fliperama86/pico-retrodigital/hardware/pico-retrodigital/pico-retrodigital.kicad_pcb

## KiCad design hardware/pico-retrodigital/pico-retrodigital.kicad_pcb (2026-08-05)

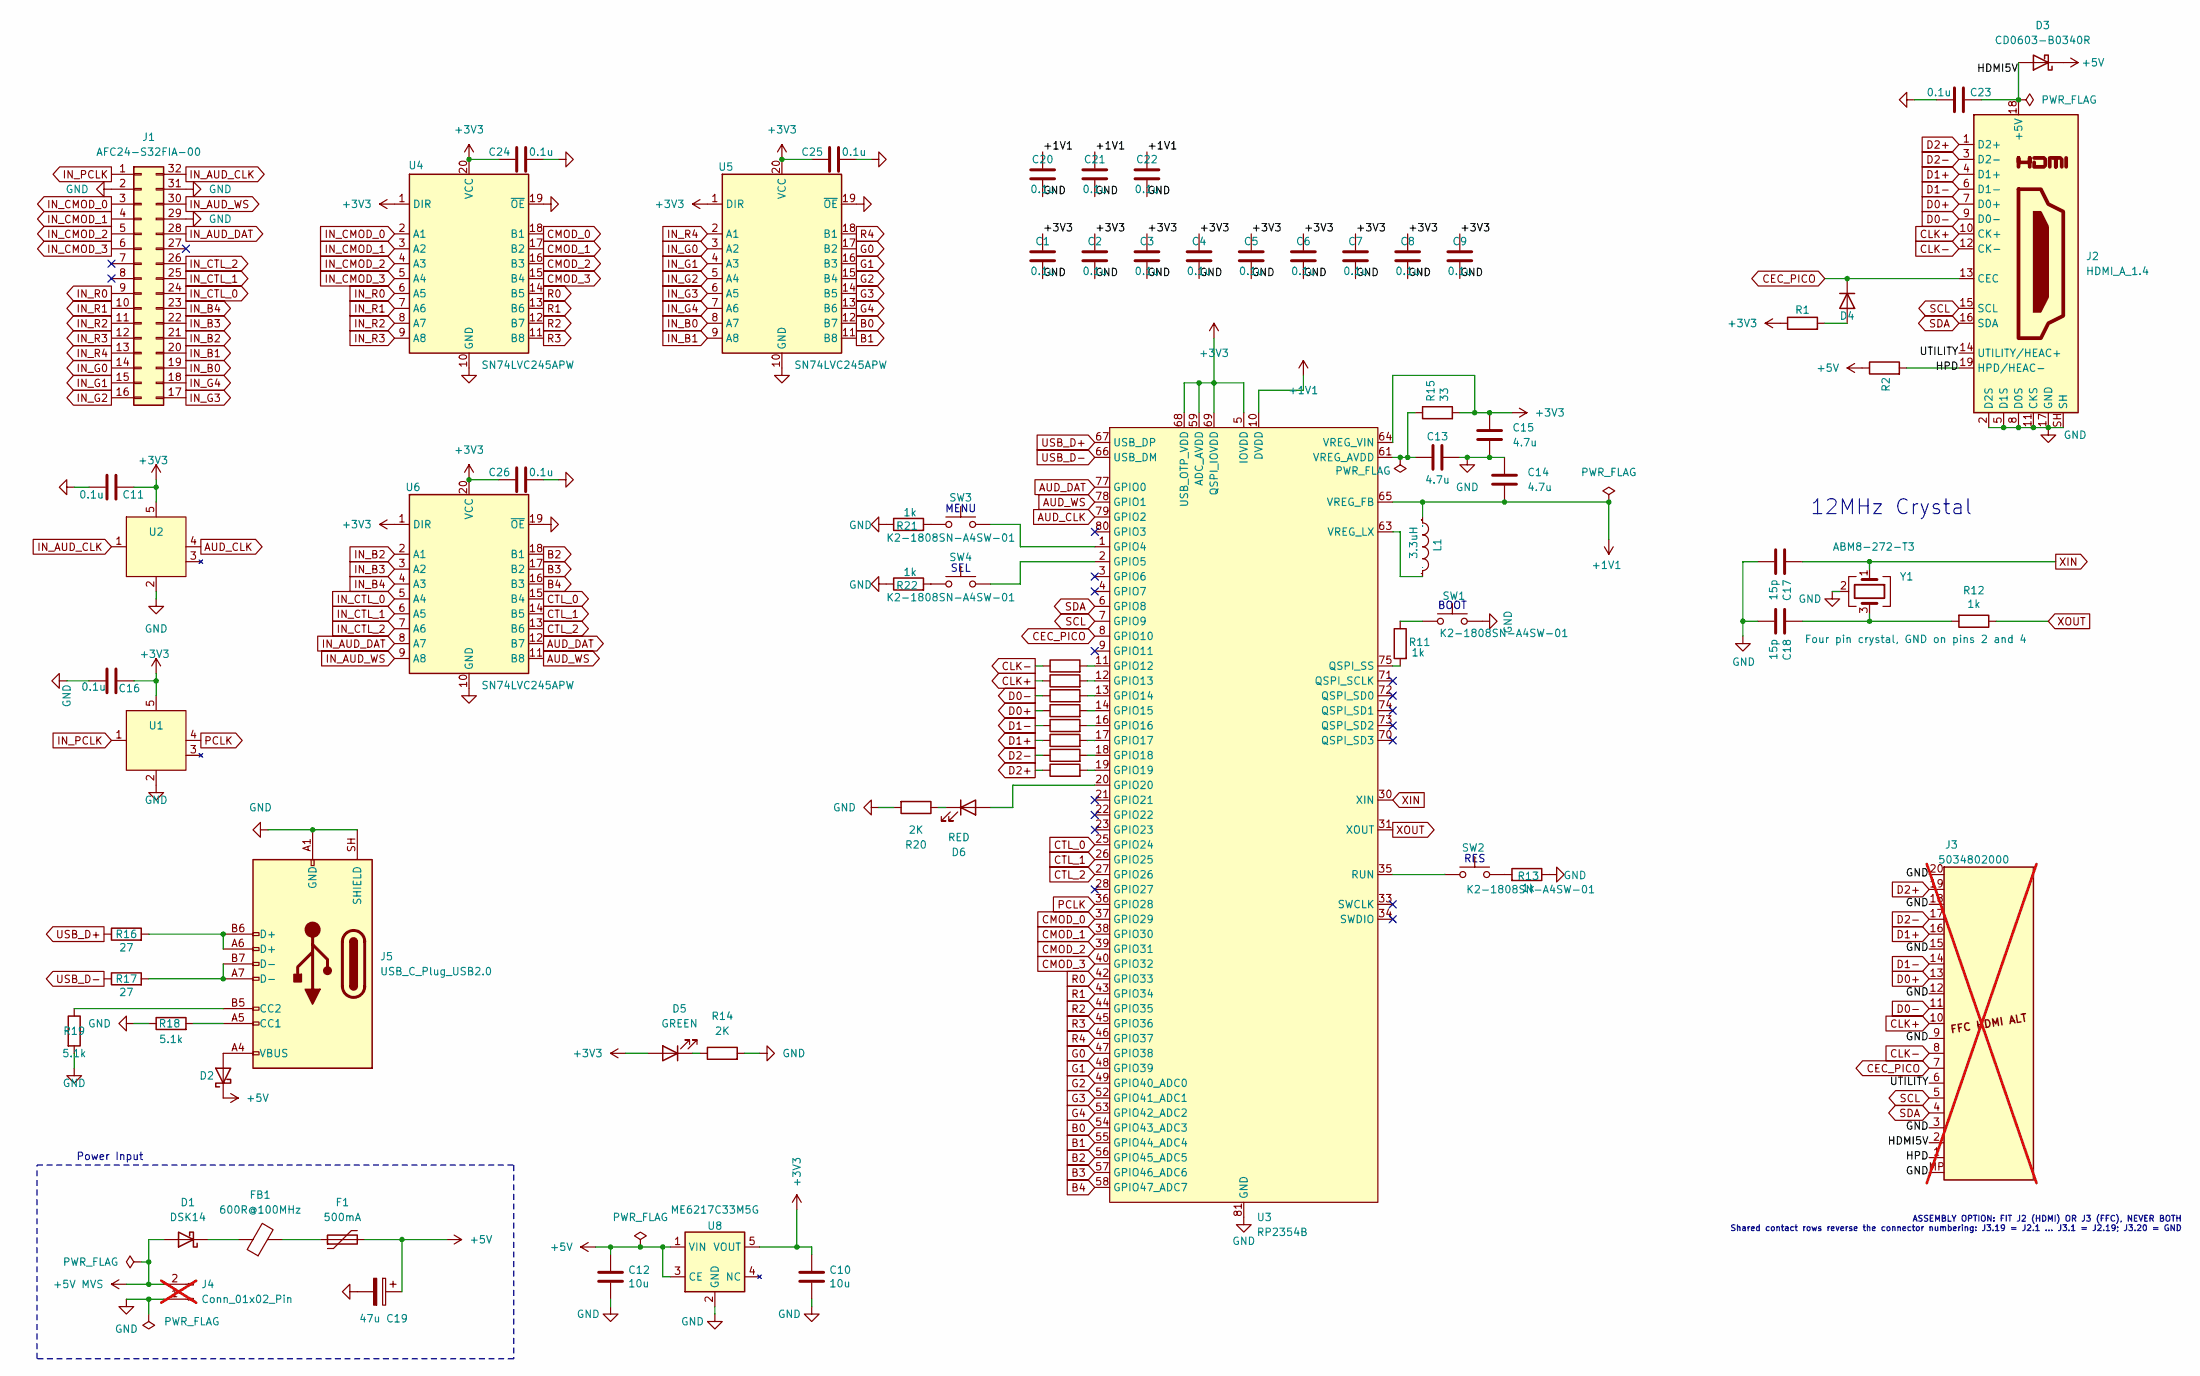
[picture p1: schematic pico-retrodigital.kicad_sch]

Parts:
C1, C3, C4, C5, C6, C7, C8, C9, C11, C16, C20, C21, C22, C23, C24, C25, C26: 0.1u; C_0402_1005Metric; LCSC C1525
C2: 0.1u; C_0603_1608Metric; LCSC C14663
C10, C12: 10u; C_0402_1005Metric; LCSC C15525
C13, C15: 4.7u; C_0402_1005Metric; LCSC C23733
C14: 4.7u; C_0603_1608Metric; LCSC C19666
C17, C18: 15p; C_0402_1005Metric; LCSC C1548
C19: 47u; C_1206_3216Metric; MPN CL31A476MPHNNNE; LCSC C96123
D1: DSK14; D_SOD-123; LCSC C7502711
D2: DSK14; D_SOD-123; MPN DSK14; LCSC C7502711
D3, D4: CD0603-B0340R; D_0603_1608Metric; MPN CD0603-B0340R; LCSC C3759853
D5: GREEN; LED_0603_1608Metric; MPN KT-0603YG; LCSC C2289
D6: RED; LED_0603_1608Metric; MPN KT-0603R; LCSC C2286
F1: 500mA; C_0603_1608Metric; MPN BSMD0603-050-6V; LCSC C883095
FB1: 600R@100MHz; C_0603_1608Metric; MPN BLM18KG601SN1D; LCSC C85833
J1: AFC24-S32FIA-00; FPC-SMD_P0.50-32P_JS_AFC24-S32FIA-00; MPN AFC24-S32FIA-00; LCSC C2908587
J2: HDMI_A_1.4; HDMI_A_Molex_208658-1001_Horizontal; MPN HDMI-001 19PCBTP; LCSC C138388
J3: 5034802000; FPC-SMD_5034802000; MPN 5034802000; LCSC C234192; not fitted
J4: Conn_01x02_Pin; JST_XA_B02B-XASK-1_1x02_P2.50mm_Vertical; MPN B02B-XASK-1(LF)(SN); LCSC C263753; not fitted
J5: USB_C_Plug_USB2.0; USB_C_Receptacle_HRO_TYPE-C-31-M-12; MPN TYPE-C-31-M-12; LCSC C165948
L1: IND-SMD_L2.0-W1.6_AOTA-B201610S3R3-101-T; Manufacturer Part AOTA-B201610S3R3-101-T; LCSC Part Name AOTA-B201610S3R3-101-T
R1: 27K; R_0402_1005Metric; LCSC C25771
R2: 10K; R_0603_1608Metric; LCSC C25804
R3, R4, R5, R6, R7, R8, R9, R10: 220; R_0402_1005Metric; LCSC C25091
R11, R12, R13, R21, R22: 1k; R_0402_1005Metric; LCSC C11702
R14, R20: 2K; R_0402_1005Metric; LCSC C4109
R15: 33; R_0402_1005Metric; LCSC C25105
R16, R17: 27; R_0603_1608Metric; LCSC C25190
R18, R19: 5.1k; R_0603_1608Metric; LCSC C23186
SW1, SW2, SW3, SW4: K2-1808SN-A4SW-01; SW_Push_1P1T_NO_Vertical_Wuerth_434133025816; LCSC C92589
U1, U2: SN74LVC1G17DBVR; SOT-23-5; LCSC C7836
U3: RP2354B; QFN-80-1EP_10x10mm_P0.4mm_EP3.4x3.4mm_ThermalVias; LCSC C39843328
U4, U5, U6: SN74LVC245APW; TSSOP-20_4.4x6.5mm_P0.65mm; LCSC C7848
U8: ME6217C33M5G; SOT-23-5; LCSC C427602
Y1: ABM8-272-T3; Crystal_SMD_3225-4Pin_3.2x2.5mm; LCSC C20625731

Connections:
+1V1: C14.2, C20.1, C21.1, C22.1, L1.1, U3.10 (DVDD), U3.32 (DVDD), U3.51 (DVDD), U3.65 (VREG_FB)
+3V3: C1.1, C2.1, C3.1, C4.1, C5.1, C6.1, C7.1, C8.1, C9.1, C10.1, C11.1, C15.1, C16.1, C24.1, C25.1, C26.1, D5.2 (A), R1.1, R15.2, U1.5 (VCC), U2.5 (VCC), U3.5 (IOVDD), U3.15 (IOVDD), U3.24 (IOVDD), U3.29 (IOVDD), U3.41 (IOVDD), U3.50 (IOVDD), U3.59 (ADC_AVDD), U3.60 (IOVDD), U3.64 (VREG_VIN), U3.68 (USB_OTP_VDD), U3.69 (QSPI_IOVDD), U3.76 (IOVDD), U4.1 (DIR), U4.20 (VCC), U5.1 (DIR), U5.20 (VCC), U6.1 (DIR), U6.20 (VCC), U8.5 (VOUT)
+5V: C12.1, C19.1, D2.1 (K), D3.1 (K), F1.2, R2.1, U8.1 (VIN), U8.3 (CE)
+5V MVS: D1.2 (A), J4.2
/HDMI5V: C23.1, D3.2 (A), J2.18 (+5V), J3.2 (+5V)
/HPD: J2.19 (HPD/HEAC-), J3.1 (HPD), R2.2
/UTILITY: J2.14 (UTILITY/HEAC+), J3.6 (UTILITY)
AUD_CLK: U2.4 (Y), U3.79 (GPIO2)
AUD_DAT: U3.77 (GPIO0), U6.12 (B7)
AUD_WS: U3.78 (GPIO1), U6.11 (B8)
B0: U3.54 (GPIO43_ADC3), U5.12 (B7)
B1: U3.55 (GPIO44_ADC4), U5.11 (B8)
B2: U3.56 (GPIO45_ADC5), U6.18 (B1)
B3: U3.57 (GPIO46_ADC6), U6.17 (B2)
B4: U3.58 (GPIO47_ADC7), U6.16 (B3)
CEC_PICO: D4.1 (K), J2.13 (CEC), J3.7 (CEC), U3.8 (GPIO10)
CLK+: J2.10 (CK+), J3.10 (CLK+), R5.1
CLK-: J2.12 (CK-), J3.8 (CLK-), R4.1
CMOD_0: U3.37 (GPIO29), U4.18 (B1)
CMOD_1: U3.38 (GPIO30), U4.17 (B2)
CMOD_2: U3.39 (GPIO31), U4.16 (B3)
CMOD_3: U3.40 (GPIO32), U4.15 (B4)
CTL_0: U3.25 (GPIO24), U6.15 (B4)
CTL_1: U3.26 (GPIO25), U6.14 (B5)
CTL_2: U3.27 (GPIO26), U6.13 (B6)
D0+: J2.7 (D0+), J3.13 (D0+), R6.1
D0-: J2.9 (D0-), J3.11 (D0-), R3.1
D1+: J2.4 (D1+), J3.16 (D1+), R8.1
D1-: J2.6 (D1-), J3.14 (D1-), R7.1
D2+: J2.1 (D2+), J3.19 (D2+), R10.1
D2-: J2.3 (D2-), J3.17 (D2-), R9.1
G0: U3.47 (GPIO38), U5.17 (B2)
G1: U3.48 (GPIO39), U5.16 (B3)
G2: U3.49 (GPIO40_ADC0), U5.15 (B4)
G3: U3.52 (GPIO41_ADC1), U5.14 (B5)
G4: U3.53 (GPIO42_ADC2), U5.13 (B6)
GND: C1.2, C2.2, C3.2, C4.2, C5.2, C6.2, C7.2, C8.2, C9.2, C10.2, C11.2, C12.2, C13.2, C14.1, C15.2, C16.2, C17.2, C18.2, C19.2, C20.2, C21.2, C22.2, C23.2, C24.2, C25.2, C26.2, J1.2, J1.29, J1.31, J2.2 (D2S), J2.5 (D1S), J2.8 (D0S), J2.11 (CKS), J2.17 (GND), J2.SH, J3.3 (GND), J3.9 (GND), J3.12 (GND), J3.15 (GND), J3.18 (GND), J3.20 (GND), J3.MP (SHIELD), J4.1, J5.A1 (GND), J5.A12 (GND), J5.B1 (GND), J5.B12 (GND), J5.SH (SHIELD), R13.1, R14.2, R18.1, R19.2, R20.2, R21.1, R22.1, SW1.1, U1.2 (GND), U2.2 (GND), U3.62 (VREG_PGND), U3.81 (GND), U4.10 (GND), U4.19 (~OE), U5.10 (GND), U5.19 (~OE), U6.10 (GND), U6.19 (~OE), U8.2 (GND), Y1.2 (G), Y1.4 (G)
IN_AUD_CLK: J1.32, U2.1 (A)
IN_AUD_DAT: J1.28, U6.8 (A7)
IN_AUD_WS: J1.30, U6.9 (A8)
IN_B0: J1.19, U5.8 (A7)
IN_B1: J1.20, U5.9 (A8)
IN_B2: J1.21, U6.2 (A1)
IN_B3: J1.22, U6.3 (A2)
IN_B4: J1.23, U6.4 (A3)
IN_CMOD_0: J1.3, U4.2 (A1)
IN_CMOD_1: J1.4, U4.3 (A2)
IN_CMOD_2: J1.5, U4.4 (A3)
IN_CMOD_3: J1.6, U4.5 (A4)
IN_CTL_0: J1.24, U6.5 (A4)
IN_CTL_1: J1.25, U6.6 (A5)
IN_CTL_2: J1.26, U6.7 (A6)
IN_G0: J1.14, U5.3 (A2)
IN_G1: J1.15, U5.4 (A3)
IN_G2: J1.16, U5.5 (A4)
IN_G3: J1.17, U5.6 (A5)
IN_G4: J1.18, U5.7 (A6)
IN_PCLK: J1.1, U1.1 (A)
IN_R0: J1.9, U4.6 (A5)
IN_R1: J1.10, U4.7 (A6)
IN_R2: J1.11, U4.8 (A7)
IN_R3: J1.12, U4.9 (A8)
IN_R4: J1.13, U5.2 (A1)
unnamed: C18.1, R12.2, Y1.3
unnamed: D1.1 (K), FB1.1
unnamed: D2.2 (A), J5.A4 (VBUS), J5.A9 (VBUS), J5.B4 (VBUS), J5.B9 (VBUS)
unnamed: D4.2 (A), R1.2
unnamed: D5.1 (K), R14.1
unnamed: D6.2 (A), U3.20 (GPIO20)
unnamed: D6.1 (K), R20.1
unnamed: F1.1, FB1.2
unnamed: J5.A5 (CC1), R18.2
unnamed: J5.B5 (CC2), R19.1
unnamed: J5.A6 (D+), J5.B6 (D+), R16.2
unnamed: J5.A7 (D-), J5.B7 (D-), R17.2
unnamed: R11.1, SW1.2
unnamed: R13.2, SW2.1
unnamed: R21.2, SW3.1
unnamed: R22.2, SW4.1
unnamed: SW3.2, U3.1 (GPIO4)
unnamed: SW4.2, U3.2 (GPIO5)
unnamed: R4.2, U3.11 (GPIO12)
unnamed: R5.2, U3.12 (GPIO13)
unnamed: R3.2, U3.13 (GPIO14)
unnamed: R6.2, U3.14 (GPIO15)
unnamed: R7.2, U3.16 (GPIO16)
unnamed: R8.2, U3.17 (GPIO17)
unnamed: R9.2, U3.18 (GPIO18)
unnamed: R10.2, U3.19 (GPIO19)
unnamed: R11.2, U3.75 (QSPI_SS)
unnamed: SW2.2, U3.35 (RUN)
unnamed: C13.1, R15.1, U3.61 (VREG_AVDD)
unnamed: L1.2, U3.63 (VREG_LX)
PCLK: U1.4 (Y), U3.36 (GPIO28)
R0: U3.42 (GPIO33), U4.14 (B5)
R1: U3.43 (GPIO34), U4.13 (B6)
R2: U3.44 (GPIO35), U4.12 (B7)
R3: U3.45 (GPIO36), U4.11 (B8)
R4: U3.46 (GPIO37), U5.18 (B1)
SCL: J2.15 (SCL), J3.5 (SCL), U3.7 (GPIO9)
SDA: J2.16 (SDA), J3.4 (SDA), U3.6 (GPIO8)
USB_D+: R16.1, U3.67 (USB_DP)
USB_D-: R17.1, U3.66 (USB_DM)
XIN: C17.1, U3.30 (XIN), Y1.1
XOUT: R12.1, U3.31 (XOUT)

Notes on the sheet:
Power Input
12MHz Crystal
SEL
ASSEMBLY OPTION: FIT J2 (HDMI) OR J3 (FFC), NEVER BOTH Shared contact rows reverse the connector numbering: J3.19 = J2.1 ... J3.1 = J2.19; J3.20 = GND
MENU
RES
BOOT

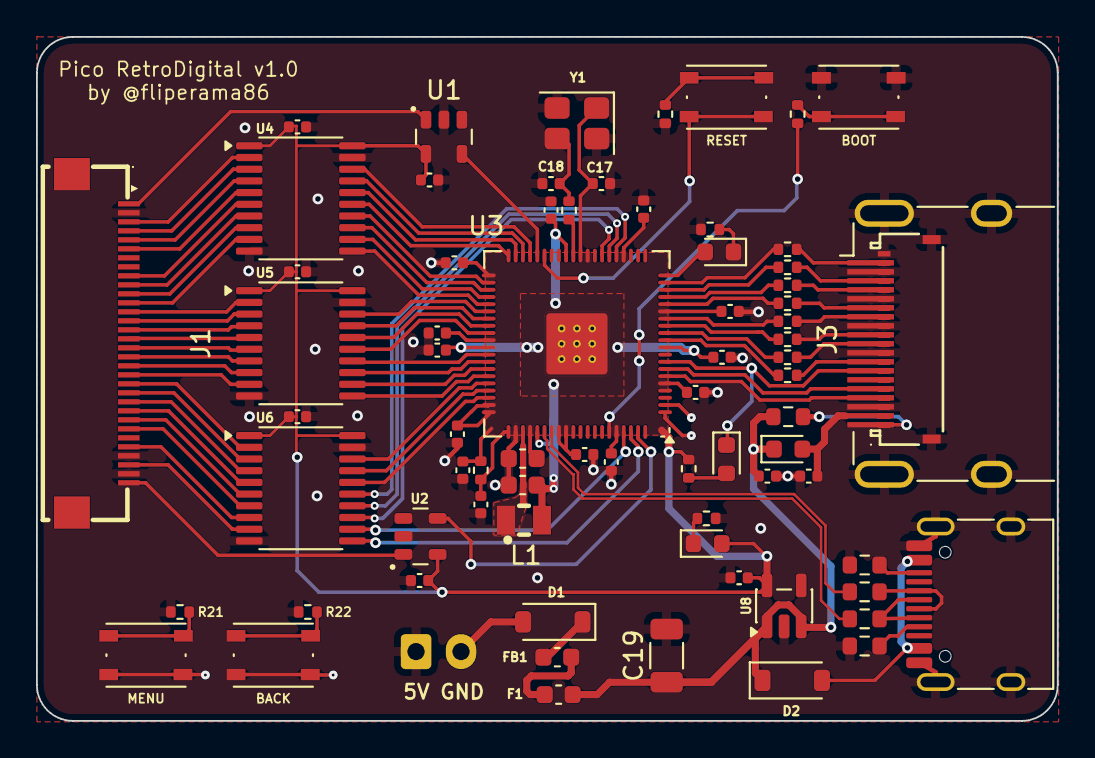
[picture p2: board hardware/pico-retrodigital/pico-retrodigital.kicad_pcb from above]

Board: 4 copper layers, 56.7 x 38.0 mm, 74 parts (0 on the bottom side), 105 nets.
