fliperama86/pico-retrodigital/hardware/hdmi_breakout/hdmi_breakout/hdmi_breakout.kicad_pcb

## KiCad design hardware/hdmi_breakout/hdmi_breakout/hdmi_breakout.kicad_pcb (2026-07-26)

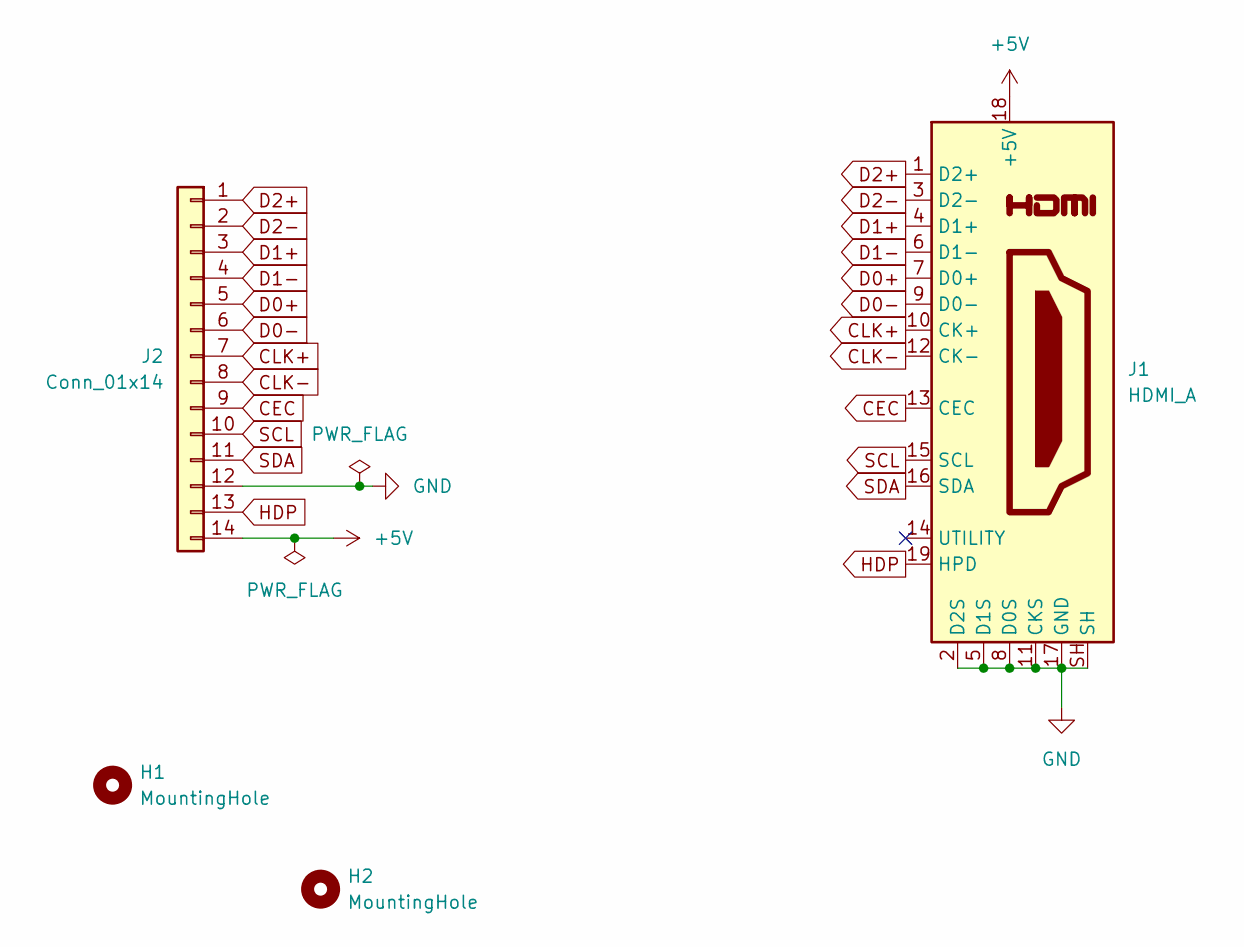
[picture p3: schematic hdmi_breakout.kicad_sch]

Parts:
H1, H2: MountingHole; MountingHole_3mm
J1: HDMI_A; HDMI_A_Molex_208658-1001_Horizontal
J2: Conn_01x14; TE_1-1734839-4_1x14-1MP_P0.5mm_Horizontal

Connections:
+5V: J1.18 (+5V), J2.14
CEC: J1.13 (CEC), J2.9
CLK+: J1.10 (CK+), J2.7
CLK-: J1.12 (CK-), J2.8
D0+: J1.7 (D0+), J2.5
D0-: J1.9 (D0-), J2.6
D1+: J1.4 (D1+), J2.3
D1-: J1.6 (D1-), J2.4
D2+: J1.1 (D2+), J2.1
D2-: J1.3 (D2-), J2.2
GND: J1.2 (D2S), J1.5 (D1S), J1.8 (D0S), J1.11 (CKS), J1.17 (GND), J1.SH, J2.12
HDP: J1.19 (HPD), J2.13
SCL: J1.15 (SCL), J2.10
SDA: J1.16 (SDA), J2.11

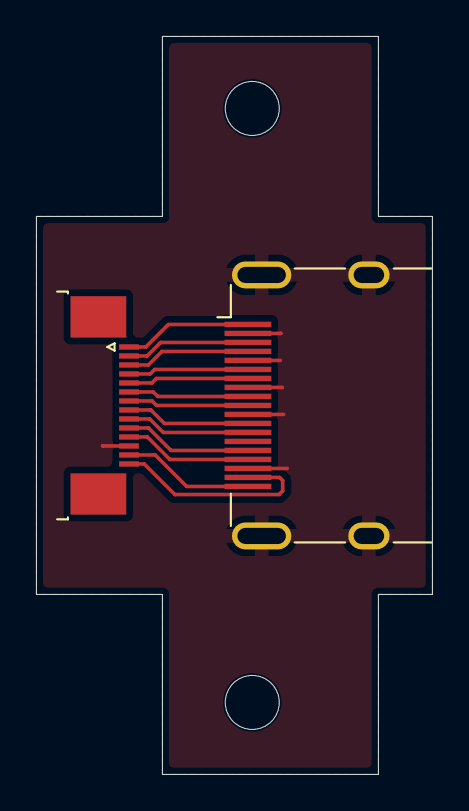
[picture p4: board hdmi_breakout.kicad_pcb from above]

Board: 2 copper layers, 22.0 x 41.0 mm, 4 parts (0 on the bottom side), 14 nets.
