fliperama86/pico-retrodigital/hardware/main-board-backup/pico-retrodigital.kicad_pcb

## KiCad design hardware/main-board-backup/pico-retrodigital.kicad_pcb (2026-04-26)

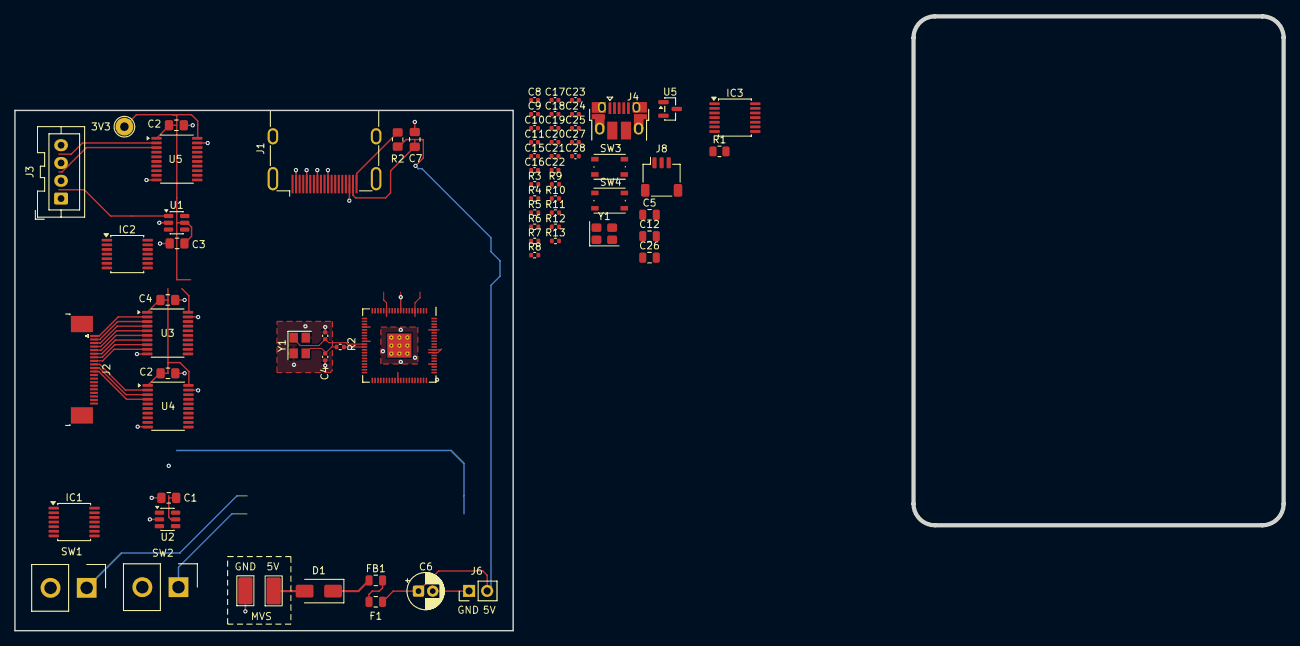
[picture p5: board hardware/main-board-backup/pico-retrodigital.kicad_pcb from above]

Board: 2 copper layers, 178.3 x 86.3 mm, 69 parts (0 on the bottom side), 46 nets.

Parts:
3V3: TestPoint_THTPad_D2.5mm_Drill1.2mm
C1, C2, C2#2, C3#2, C4#2, C7: 0.1u; C_0805_2012Metric_Pad1.18x1.45mm_HandSolder
C3, C4, C10, C11: 15p; C_0402_1005Metric
C5, C12, C26: 10u; C_0805_2012Metric
C6: 47u; CP_Radial_D5.0mm_P2.00mm
C8, C15, C18, C19, C20, C21, C22, C23, C24, C25, C27, C28: 100n; C_0402_1005Metric
C9: DNF; C_0402_1005Metric
C16, C17: 4.7u; C_0402_1005Metric
D1: SS14; D_SMA
F1: Polyfuse; C_0805_2012Metric
FB1: FerriteBead; C_0805_2012Metric
IC1, IC2, IC3: TXU0104PWR; TSSOP-14_4.4x5mm_P0.65mm
J1: HDMI_A; HDMI_A_Molex_208658-1001_Horizontal
J2: Conn_02x05_Top_Bottom; TE_2-1734839-0_1x20-1MP_P0.5mm_Horizontal
J3: Conn_01x04; JST_XA_B04B-XASK-1_1x04_P2.50mm_Vertical
J4: USB_B_Micro; USB_Micro-B_Amphenol_10103594-0001LF_Horizontal
J6: Conn_01x02_Pin; PinHeader_1x02_P2.54mm_Vertical
J8: SM03B-SRSS-TB; JST_SH_SM03B-SRSS-TB_1x03-1MP_P1.00mm_Horizontal
R1: 27K; R_0805_2012Metric
R2, R8, R9, R11: 1k; R_0402_1005Metric
R2#2: 10K; R_0805_2012Metric_Pad1.20x1.40mm_HandSolder
R3, R5, R6, R7: DNF; R_0402_1005Metric
R4: 0; R_0402_1005Metric
R10: 33; R_0402_1005Metric
R12, R13: 27; R_0402_1005Metric
SW1: MENU; Samtec_HPM-02-01-x-S_Straight_1x02_Pitch5.08mm
SW2: BACK; Samtec_HPM-02-01-x-S_Straight_1x02_Pitch5.08mm
SW3, SW4: SW_Push; SW_Push_1P1T_NO_Vertical_Wuerth_434133025816
U1: RP2350_80QFN; RP2350-QFN-80-1EP_10x10_P0.4mm_EP3.4x3.4mm_ThermalVias
U1#2: A_BUFF; SOT-23-6
U2: V_BUFF; SOT-23-6
U3: RG_LVS; TSSOP-20_4.4x6.5mm_P0.65mm
U4: GB_LVS; TSSOP-20_4.4x6.5mm_P0.65mm
U5: AP2127K-3.3TRG1; SOT-23
U5#2: AV_LVS; TSSOP-20_4.4x6.5mm_P0.65mm
Y1, Y1#2: ABM8-272-T3; Crystal_SMD_3225-4Pin_3.2x2.5mm

Connections:
+1V1: C15.1, C17.1, C18.1, U1.10 (DVDD), U1.32 (DVDD), U1.51 (DVDD), U1.65 (VREG_FB)
+3V3: 3V3.1, C1.1, C2.1, C2#2.1, C3#2.1, C4#2.1, C8.1, C9.1, C12.1, C19.1, C20.1, C21.1, C22.1, C23.1, C24.1, C25.1, C26.1, C27.1, C28.1, IC1.8 (OE), IC1.14 (VCCB), IC2.8 (OE), IC2.14 (VCCB), R1.1, R6.1, R7.1, R10.1, U1.5 (IOVDD), U1.15 (IOVDD), U1.24 (IOVDD), U1.29 (IOVDD), U1.41 (IOVDD), U1.50 (IOVDD), U1.59 (ADC_AVDD), U1.60 (IOVDD), U1.64 (VREG_VIN), U1.68 (USB_OTP_VDD), U1.69 (QSPI_IOVDD), U1.76 (IOVDD), U1#2.5 (V_{CC}), U2.5 (V_{CC}), U3.1 (DIR), U3.20 (VCC), U4.1 (DIR), U4.20 (VCC), U5#2.1 (DIR), U5#2.20 (VCC)
+5V: C6.1, C7.1, F1.2, IC1.1 (VCCA), IC2.1 (VCCA), J1.18 (+5V), J6.2, R2#2.1
/RP2350B/FLASH2_SS: R5.2, R7.2
/RP2350B/FLASH_SS: R3.2, R4.2, R6.2
/RP2350B/GPIO0: R3.1, R5.1
/RP2350B/QSPI_SS: R4.1, R11.1
/RP2350B/USB_D+: J4.3 (D+), R12.1
/RP2350B/USB_D-: J4.2 (D-), R13.1
/RP2350B/VREG_AVDD: C16.1, R10.2
/RP2350B/XIN: C10.1, Y1.1
/RP2350B/~USB_BOOT: R11.2, SW3.2
/XIN: C3.1, U1.30 (XIN), Y1#2.1
/XOUT: R2.1, U1.31 (XOUT)
CEC_PICO: J1.13 (CEC), R1.2
GND: C1.2, C2.2, C2#2.2, C3.2, C3#2.2, C4.2, C4#2.2, C5.2, C6.2, C7.2, C8.2, C9.2, C10.2, C11.2, C12.2, C15.2, C16.2, C17.2, C18.2, C19.2, C20.2, C21.2, C22.2, C23.2, C24.2, C25.2, C26.2, C27.2, C28.2, IC1.7 (GND), IC2.7 (GND), J1.2 (D2S), J1.5 (D1S), J1.8 (D0S), J1.11 (CKS), J1.17 (GND), J1.SH, J4.5 (GND), J4.6 (Shield), J6.1, J8.2, J8.MP (MountPin), R8.2, SW1.2, SW2.2, SW3.1, U1.62 (VREG_PGND), U1.81 (GND), U1#2.2 (GND), U2.2 (GND), U3.10 (GND), U3.19 (~OE), U4.10 (GND), U4.19 (~OE), U5.2 (GND), U5#2.10 (GND), U5#2.19 (~OE), Y1.2, Y1.4, Y1#2.2, Y1#2.4
IN_A1: IC2.3 (A2), J3.2
IN_A2: IC2.4 (A3), J3.3
IN_A3: IC2.5 (A4), J3.4
IN_ACLK: IC2.2 (A1), J3.1
IN_B0: J2.11, U4.4 (A3)
IN_B1: J2.12, U4.5 (A4)
IN_B2: J2.13, U4.6 (A5)
IN_B3: J2.14, U4.7 (A6)
IN_B4: J2.15, U4.8 (A7)
IN_C1: IC1.3 (A2), J2.16
IN_C2: IC1.4 (A3), J2.17
IN_C3: IC1.5 (A4), J2.18
IN_G0: J2.6, U3.7 (A6)
IN_G1: J2.7, U3.8 (A7)
IN_G2: J2.8, U3.9 (A8)
IN_G3: J2.9, U4.2 (A1)
IN_G4: J2.10, U4.3 (A2)
IN_PCLK: IC1.2 (A1), J2.19
IN_R0: J2.1, U3.2 (A1)
IN_R1: J2.2, U3.3 (A2)
IN_R2: J2.3, U3.4 (A3)
IN_R3: J2.4, U3.5 (A4)
IN_R4: J2.5, U3.6 (A5)
unnamed: C4.1, R2.2, Y1#2.3
unnamed: C11.1, R9.2, Y1.3
unnamed: D1.1 (K), FB1.1
unnamed: F1.1, FB1.2
unnamed: J1.19 (HPD), R2#2.2
unnamed: R8.1, SW4.1
VBUS: C5.1, J4.1 (VBUS), U5.1 (VIN)
