fliperama86/pico-retrodigital/(commit log)

2026-01-20 Copy kicad from neopico-hd
    [pico-retrodigital.kicad_pcb, pico-retrodigital.kicad_sch]
2026-04-26 USB C
    [pico-retrodigital.kicad_pcb, pico-retrodigital.kicad_sch, rp2350b.kicad_sch]
2026-04-28 PCB fixes
    [pico-retrodigital.kicad_pcb, pico-retrodigital.kicad_sch]
2026-05-03 Square-shaped PCB
    [pico-retrodigital.kicad_pcb, pico-retrodigital.kicad_sch]
2026-05-14 Add 3V3 LDO regulator, reset/boot buttons, and pad default tweaks
    - Add ME6217C33M5G LDO symbol and integrate into schematic
    - Add RES1 (reset) and BOOT1 (boot) push buttons
    - Update default pad size in board setup
    - Ignore kicad-jlcpcb-tools plugin local state (jlcpcb/)
    [pico-retrodigital.kicad_pcb, pico-retrodigital.kicad_sch]
2026-05-14 Clean up PCB DRC: thermal reliefs, via drills, small-via rule
    - Bump all 0.6 mm vias to 0.3 mm drill (was 0.25); leave 9 small
    0.45/0.2 vias on +1V1 and CTL_0..2 untouched for tight routing
    - Update Default netclass via_drill to 0.3
    - Shrink thermal_bridge_width on both GND zones to 0.25 mm
    - Switch U3 GND (pads 62, 81) and +1V1 (pads 10, 32, 51, 65) to
    solid zone connection for better grounding/heat dissipation
    - Drop min_resolved_spokes from 2 to 1 (single-spoke thermals are
    electrically fine for reflow-assembled boards)
    - Add .kicad_dru with a scoped exception allowing 0.45/0.2 vias only
    on +1V1, CTL_0, CTL_1, CTL_2 — other nets still require 0.5/0.3
    - Ignore *_drc_violations.js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
    [pico-retrodigital.kicad_pcb]
2026-05-14 Refresh footprints from library; lower min silk text to 0.5 mm
    - Pull current library copies for standard 0402/0603 R, C, D and FFC
    connector footprints (clears 29 of 36 lib_footprint_mismatch warnings
    and the 2 silk_over_copper)
    - Drop min_text_height from 0.8 to 0.5 mm to match standard silk text
    on small SMD parts (clears 14 text_height warnings)
    [pico-retrodigital.kicad_pcb]
2026-05-14 Update PCB
    [pico-retrodigital.kicad_pcb, pico-retrodigital.kicad_sch]
2026-05-14 Add JLCPCB part numbers
    [pico-retrodigital.kicad_pcb, pico-retrodigital.kicad_sch]
2026-07-25 Update CI for current action runtimes
2026-07-26 Add breakout board
    [hdmi_breakout.kicad_pcb, hdmi_breakout.kicad_sch, pico-retrodigital.kicad_pcb]
2026-07-26 Add SNES USB frame capture with PIO-side frame sync
    Bring-up of SNES digital RGB capture for the Pico RetroDigital board:
    - Remap SNES capture pins to the PCB layout (RGB555 on GP33-GP47,
    HBLANK/VBLANK/PCLK on GP24/GP25/GP28) and add the pico_retrodigital
    RP2354B board definition
    - Move frame synchronization into the snes_hard_sync PIO program: the
    CPU arms capture at any point and the PIO waits for VBLANK, starting
    capture at the first HBLANK falling edge after it falls, cycle-exact
    and independent of CPU/USB timing
    - Add a standalone USB CDC diagnostic target serving CRC-protected
    256x224 RGB565 frames via whole-frame DMA (PRDF protocol)
    - Port the neopico_hd SNES backend to t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
2026-07-26 Fix lint: clang-format capture main.c, add missing EOF newline
    [main.c]
2026-07-27 Add SNES QSB signal telemetry and brightness-corrected capture
    - Protocol v3: per-frame brightness nibble and PIXEL_VALID level in the
    header, plus a CRC-protected trailer carrying a per-line brightness
    array and a per-pixel validity mask plane
    - Sample the QSB $2100 brightness latch (CMOD_0-3 on GP29-32) at every
    HBLANK falling edge via a second PIO SM and apply it to pixels through
    scale tables, so fades render as they do on analog output
    - Capture a per-pixel PIXEL_VALID mask via a third PIO SM in cycle-exact
    lockstep with the RGB capture (pio2 standalone, pio0 in neopico_hd)
    - PIXEL_VALID gating implemented but disabled by default: /OVER is
    pre-priority (asserted under sprite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
    [capture_snes_usb_frame.py, main.c, snes_pins.h, stream_snes_usb_video.py, video_capture_snes.c]
2026-07-27 Import SNES hardware reference docs
    Copy the SNES 2-chip reference documentation from the exploration
    project into docs/snes/, platform-scoped so future MVS docs can sit
    alongside: PPU1/PPU2/CPU/APU/bus/connector references, the digital AV
    mod pin reference, capture bring-up notes, the project reference list,
    and the full 119-post shmups.system11.org digital-mod thread crawl,
    plus a new index README. Content imported verbatim except whitespace
    and end-of-file normalization applied by repo lint hooks.
2026-08-05 Two HDMI out connectors
    [pico-retrodigital.kicad_pcb, pico-retrodigital.kicad_sch]
2026-08-05 Source everything from JLC: LCSC part fill, connector swaps, fab export fixes
    - Fill LCSC/MPN fields across the BOM (fill_lcsc script + curated picks);
    replace generic values with specific parts (diodes, LEDs, polyfuse,
    ferrite bead, switches)
    - C19: SMD electrolytic -> 47uF 1206 MLCC (keeps Economic assembly)
    - J1/J3: TE 1734839 FFC -> LCSC-stocked double-sided-contact parts
    (AFC24-S32FIA-00 / Molex 5034802000), project-local footprints
    - J5: GCT USB4105 -> HRO TYPE-C-31-M-12 (C165948)
    - D3/D4: SS14 -> true 0603 Schottky (CD0603-B0340R)
    - Fabrication Toolkit rotation offsets for J2/U3; J3/J4 DNP and
    excluded from BOM/CPL; remove duplicate C5 footprint
    [pico-retrodigital.kicad_pcb, pico-retrodigital.kicad_sch]
2026-08-05 Add SW3/SW4 user buttons on GPIO4/GPIO5; 4-layer board
    - Two new pushbuttons (same K2-1808SN as BOOT/RES) with 1k series
    resistors to GND, routed on In1.Cu
    - Board converted to 4 copper layers, JLC7628 1.6mm stackup documented;
    inner layers are plain signal layers
    - USB-C J5: FT Position Offset 1.42mm (JLC part origin vs KiCad anchor,
    measured via shell-hole alignment against JLC's own footprint)
    - Restore GPIO6 no-connect marker
    [pico-retrodigital.kicad_pcb, pico-retrodigital.kicad_sch]
2026-08-05 Full JCLPCB parts filled
    [pico-retrodigital.kicad_pcb, pico-retrodigital.kicad_sch]
